kauberry/esp8266-garage-door-opener/README.md

# esp8266-garage-door-opener
An IoT garage door opener using MQTT for status reporting and web api's for control functions
