kauberry/esp8266-garage-door-opener/hardware/schematics/GDO As Built Schematic (Rough).pdf

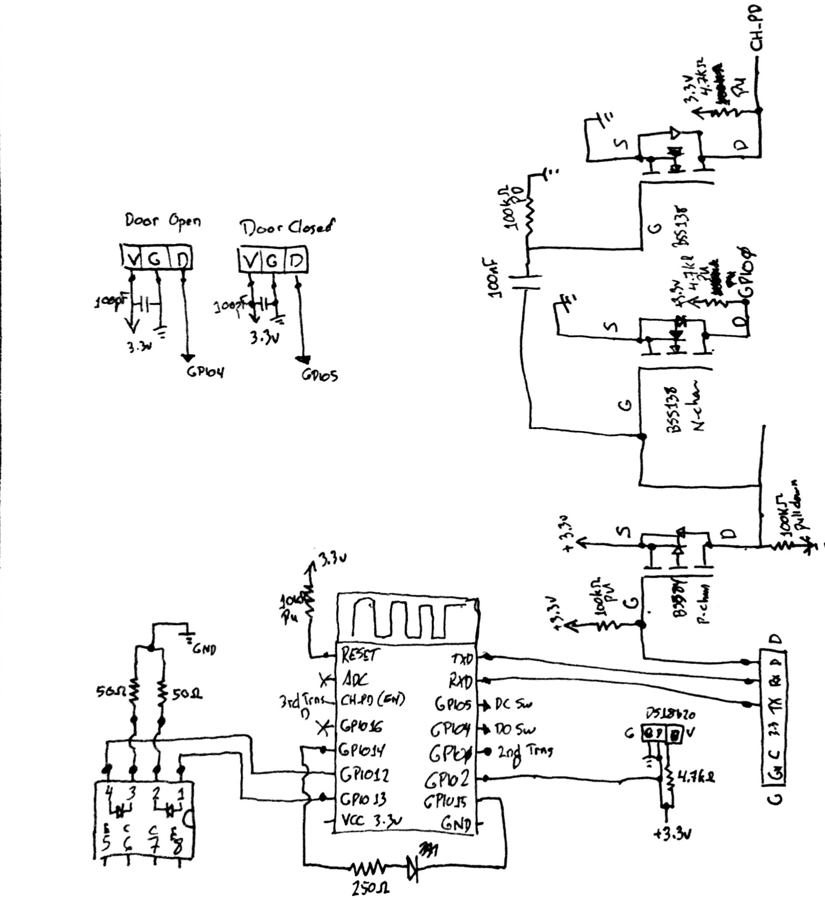
[picture p1: page 1]
