kauberry/esp8266-garage-door-opener/hardware/mounting/sketchup files/Combined.stl

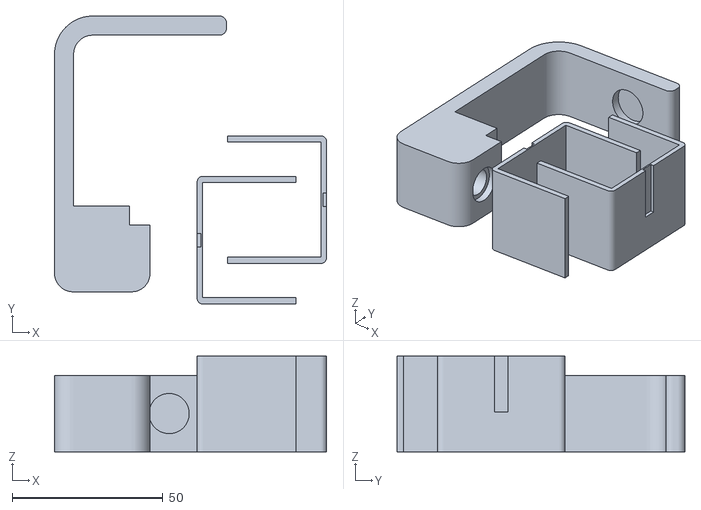
[picture p2: CAD file, 2017-11-30]
hardware/mounting/sketchup files/Combined.stl
90.4 x 95.7 x 31.8
