kauberry/esp8266-garage-door-opener/hardware/mounting/stl files/Sensor Mount v4.stl

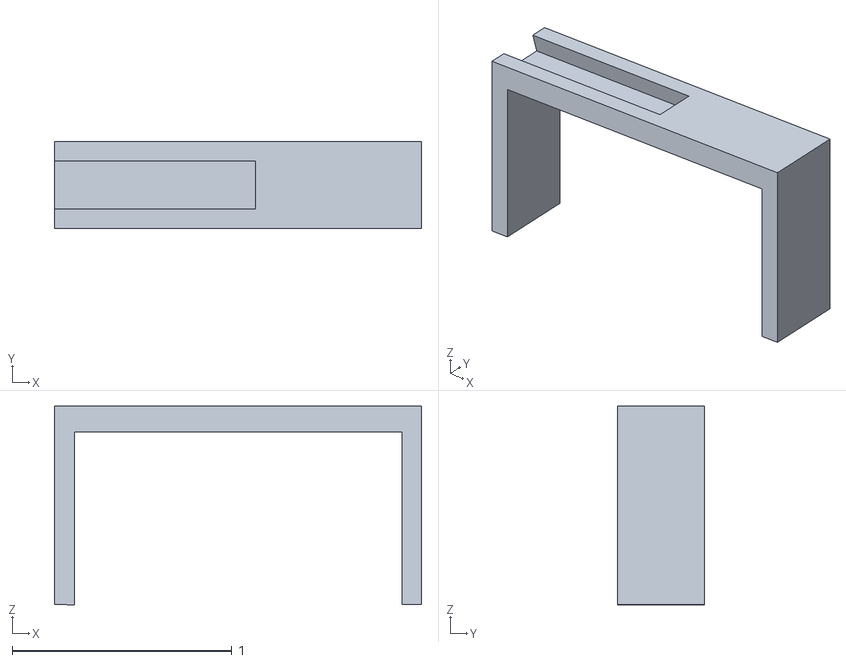
[picture p3: CAD file, 2017-11-30]
hardware/mounting/stl files/Sensor Mount v4.stl
1.67 x 0.394 x 0.903
