kauberry/esp8266-garage-door-opener/hardware/mounting/stl files/Magnet_mount - Rev 4.stl

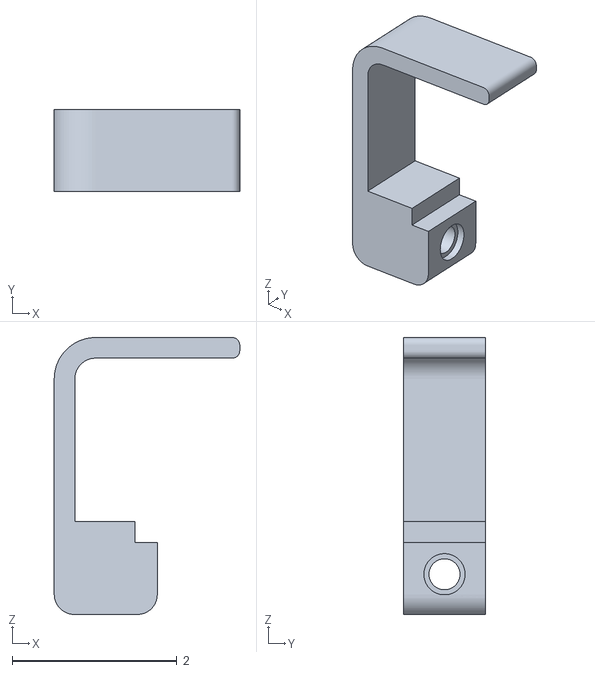
[picture p4: CAD file, 2016-04-26]
hardware/mounting/stl files/Magnet_mount - Rev 4.stl
2.25 x 1.00 x 3.36
