kauberry/esp8266-garage-door-opener/hardware/mounting/stl files/Sensor Mount v3.stl

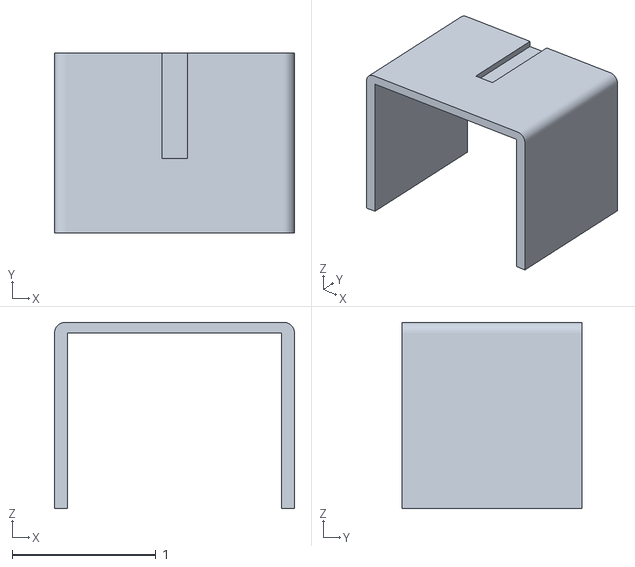
[picture p5: CAD file, 2016-04-26, an earlier design]
hardware/mounting/stl files/Sensor Mount v3.stl
1.67 x 1.25 x 1.30
