kauberry/esp8266-garage-door-opener/hardware/mounting/stl files/Magnet_mount.stl

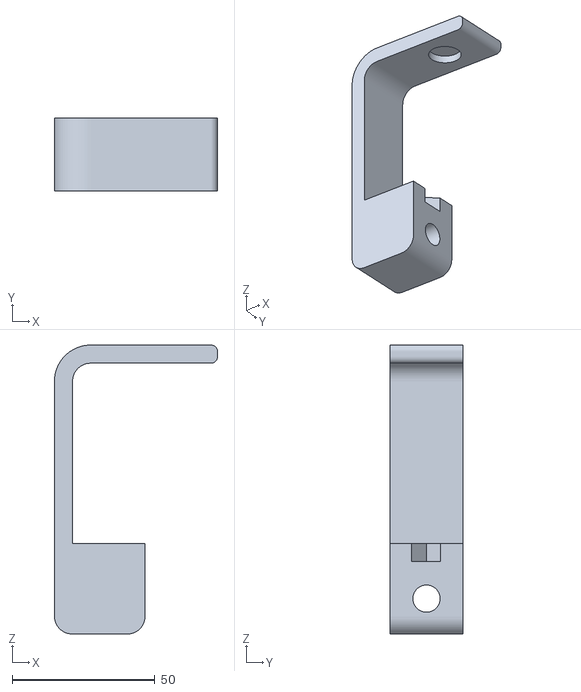
[picture p6: CAD file, 2016-04-25, an earlier design]
hardware/mounting/stl files/Magnet_mount.stl
57.1 x 25.4 x 101.2
