kauberry/esp8266-garage-door-opener/hardware/mounting/stl files/Magnet_mount - Rev 3.stl

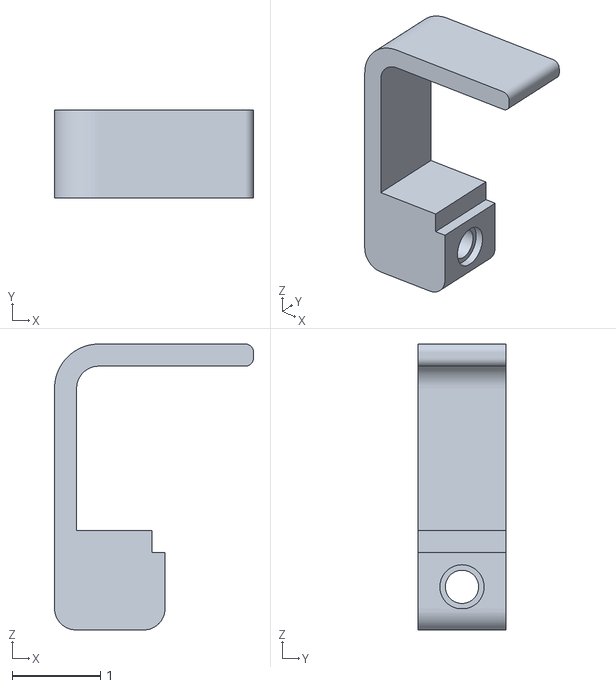
[picture p7: CAD file, 2016-04-25, an earlier design]
hardware/mounting/stl files/Magnet_mount - Rev 3.stl
2.25 x 1.00 x 3.23
