kauberry/esp8266-garage-door-opener/(list of files, cad)

Other CAD files:
hardware/mounting/stl files/Sensor Mount v2.stl
hardware/mounting/stl files/Sensor Mount v1.stl
hardware/mounting/sketchup files/Combined.skp
hardware/mounting/sketchup files/Garage Door Rail Outline.skp
hardware/mounting/sketchup files/Garage Door Rail.skp
hardware/mounting/sketchup files/Garage Monitor Enclosure.skp
hardware/mounting/sketchup files/Magnet_mount - Rev 2.skp
hardware/mounting/sketchup files/Magnet_mount - Rev 3.skp
hardware/mounting/sketchup files/Magnet_mount - Rev 4.skp
hardware/mounting/sketchup files/Magnet_mount.skp
hardware/mounting/sketchup files/Sensor Mount v2.skp
hardware/mounting/sketchup files/Sensor Mount v3.skp
hardware/mounting/sketchup files/Sensor Mount v4.skp
hardware/mounting/sketchup files/Sensor Mount.skp
