kauberry/esp8266-garage-door-opener/hardware/boards/GDOv5 Board/GDOv5 Board.brd

## EAGLE design hardware/boards/GDOv5 Board/GDOv5 Board.brd (2016-07-12)

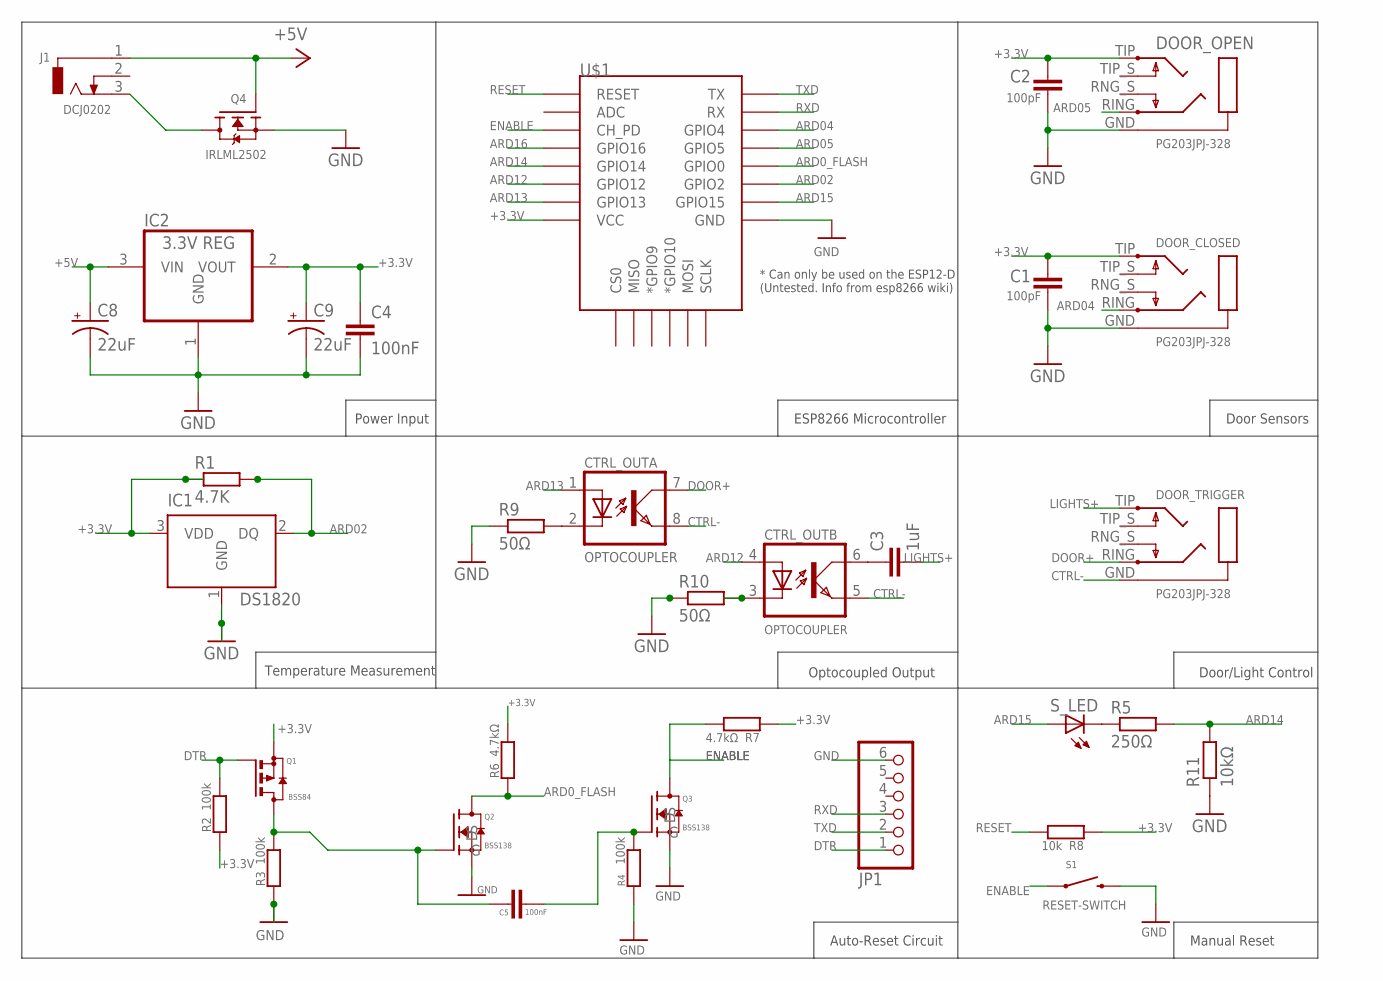
[picture p8: schematic GDOv5 Board.sch]

Parts:
C1, C2: 100pF; C1206
C3: 1uF; 1206
C4, C5: 100nF; C1206
C8, C9: 22uF; EIA3216
CTRL_OUT: OPTOCOUPLER; DIL08
DOOR_CLOSED: PG203JPJ-328; PG203J
DOOR_OPEN: PG203JPJ-328; PG203J
DOOR_TRIGGER: PG203JPJ-328; PG203J
IC1: DS1820; TO-92
IC2: 3.3V REG; SOT223
J1: DCJ0202
JP1: PINHD-1X6; 1X06
Q1: BSS84; SOT23
Q2, Q3: BSS138
Q4: IRLML2502; SOT23
R1: 4.7K; M3216
R2, R3, R4: 100k; M3216
R5: 250Ω; M3216
R6, R7: 4.7kΩ; M3216
R8: 10k; M3216
R9, R10: 50Ω; M3216
R11: 10kΩ; M3216
S1: RESET-SWITCH; TACTILE-SWITCH-1101NE
S_LED: LED5MM
U$1: ESP12ESMD; ESP12E-SMD

Connections:
+3.3V: C1.1, C2.1, C4.1, C9.A (+), DOOR_CLOSED.TIP (5), DOOR_OPEN.TIP (5), IC1.3 (VDD), IC2.2 (VOUT), Q1.2 (S), R1.1, R2.1, R6.2, R7.1, R8.1, U$1.VCC
+5V: C8.A (+), IC2.3 (VIN), J1.1, Q4.1 (G)
ARD0_FLASH: Q2.D, R6.1, U$1.GPIO0
ARD02: IC1.2 (DQ), R1.2, U$1.GPIO2
ARD04: DOOR_CLOSED.RING (2), U$1.GPIO4
ARD05: DOOR_OPEN.RING (2), U$1.GPIO5
ARD12: CTRL_OUT.4 (A), U$1.GPIO12
ARD13: CTRL_OUT.1 (A), U$1.GPIO13
ARD14: R5.2, R11.2, U$1.GPIO14
ARD15: S_LED.A, U$1.GPIO15
ARD16: U$1.GPIO16
CTRL-: CTRL_OUT.5 (EMIT), CTRL_OUT.8 (EMIT), DOOR_TRIGGER.GND (1)
DOOR+: CTRL_OUT.7 (COL), DOOR_TRIGGER.RING (2)
DTR: JP1.1, Q1.1 (G), R2.2
ENABLE: Q3.D, R7.2, S1.P$1 (1), U$1.CH_PD
GND: C1.2, C2.2, C4.2, C8.C (-), C9.C (-), DOOR_CLOSED.GND (1), DOOR_OPEN.GND (1), IC1.1 (GND), IC2.1 (GND), JP1.6, Q2.S, Q3.S, Q4.2 (S), R3.1, R4.1, R9.1, R10.1, R11.1, S1.P$2 (2), U$1.GND
LIGHTS+: C3.2, DOOR_TRIGGER.TIP (5)
unnamed: J1.3, Q4.3 (D)
unnamed: C5.2, Q3.G, R4.2
unnamed: C3.1, CTRL_OUT.6 (COL)
unnamed: R5.1, S_LED.K (C)
unnamed: C5.1, Q1.3 (D), Q2.G, R3.2
unnamed: CTRL_OUT.2 (C), R9.2
unnamed: CTRL_OUT.3 (C), R10.2
RESET: R8.2, U$1.RESET
RXD: JP1.3, U$1.RXD0 (RX)
TXD: JP1.2, U$1.TXD0 (TX)

Notes on the sheet:
Power Input
Temperature Measurement
ESP8266 Microcontroller
Optocoupled Output
Door Sensors
Door/Light Control
Auto-Reset Circuit
Manual Reset

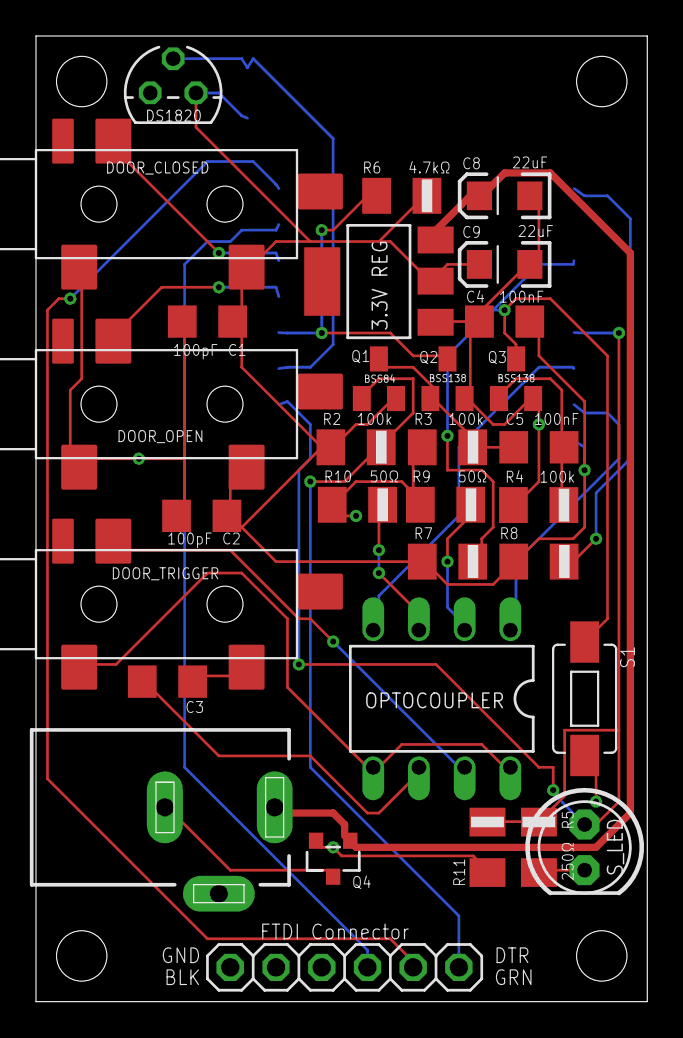
[picture p9: board GDOv5 Board.brd from above]

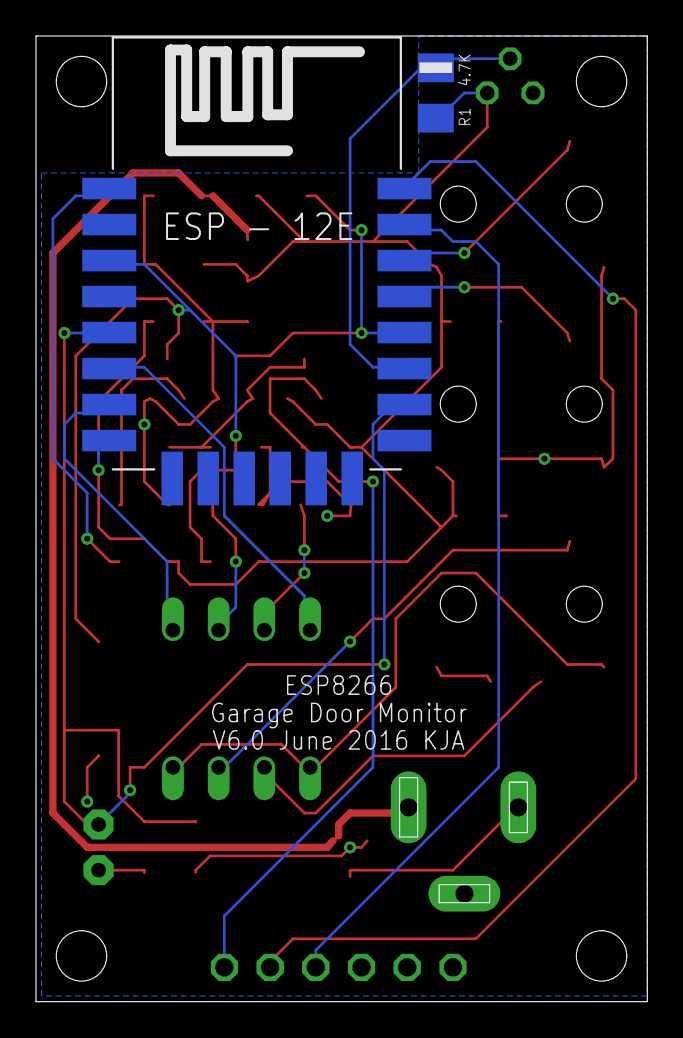
[picture p10: board GDOv5 Board.brd from below]

Board: 2 copper layers, 34.0 x 53.6 mm, 33 parts (2 on the bottom side), 26 nets.
