kauberry/esp8266-garage-door-opener/(commit log)

2016-04-20 Adding initial Eagle files
    [GDOv5 Board.sch]
2016-04-21 Adding sensor mount Sketchup file
    [Sensor Mount.skp]
2016-04-25 Updating model files for mounting hardware
    [Garage Door Rail Outline.skp, Garage Door Rail.skp, Magnet_mount - Rev 2.skp, Magnet_mount - Rev 3.skp, Magnet_mount - Rev 3.stl, Magnet_mount.skp, Magnet_mount.stl, Sensor Mount - Rev 1.stl]
2016-04-25 Adding initial EagleCAD files for controller board
    [GDOv5 Board.brd, GDOv5 Board.sch]
2016-04-25 Updating routing and layout
    [GDOv5 Board.brd, GDOv5 Board.sch]
2016-04-26 Mostly final board design
    [GDOv5 Board.brd, GDOv5 Board.sch]
2016-04-26 Closer to final board design
    [GDOv5 Board.brd, GDOv5 Board.sch]
2016-04-26 Added dimensions to board layout
    [GDOv5 Board.brd]
2016-04-26 Added first cut at a 3D printed enclosure
    [Garage Monitor Enclosure.skp]
2016-04-26 Updated sensor and magnet mounts
    [Magnet_mount - Rev 4.skp, Magnet_mount - Rev 4.stl, Sensor Mount v3.skp, Sensor Mount v3.stl]
2016-04-27 Added resistor for optocoupler inputs
    [GDOv5 Board.brd, GDOv5 Board.sch]
2016-04-29 More board tweaks
    [GDOv5 Board.brd, GDOv5 Board.sch]
2016-05-11 Replacing 3.5mm Jack with SMT design
    [GDOv5 Board.brd, GDOv5 Board.sch]
2016-05-11 Redesigning main board for more SMT components
    [GDOv5 Board.brd, GDOv5 Board.sch]
2016-05-11 Switching over to ESP-12e
2016-05-13 Updating main board files
    [GDOv5 Board.brd, GDOv5 Board.sch]
2016-05-15 Finalized version of board for OshPark
    [GDOv5 Board.brd, GDOv5 Board.sch]
2016-05-16 Fixing bad pull down connection in auto-reset circuit
    [GDOv5 Board.brd, GDOv5 Board.sch]
2016-05-31 Added pullup resistor for GPIO0
    [GDOv5 Board.brd, GDOv5 Board.sch]
2016-06-15 Fixing Board issues
    [GDOv5 Board.brd, GDOv5 Board.sch]
2016-06-20 Updating board to better match prototype design
    [GDOv5 Board.brd, GDOv5 Board.sch]
2016-06-20 Fixing state indicator LED's to update immediately on startup Increasing delay between mandatory reporting intervals for temperature
    [garage_monitor_controller.ino]
2016-06-21 Tweaked power rails and updated descriptive text before sending to fab
    [GDOv5 Board.brd, GDOv5 Board.sch]
2016-07-12 Board Design: Changed power supply buffer caps from 10µF to 22µF. Flipped Status LED connections for proper polarity. Added 10kΩ on GPIO15 to match with adapter board design on prototype.
    [GDOv5 Board.brd, GDOv5 Board.sch]
2016-07-12 Software: More fixes for configuration logic. Removed SPIFFS conf file loading for now. Added code to handle the additional external temperature probe
    [garage_monitor_controller.ino]
2016-11-10 Updates to mounting hardware for better fit and clearance
    [Combined.skp, Combined.stl, Magnet_mount - Rev 4.skp, Sensor Mount v4.skp]
2017-11-30 Pushing updated hardware and Eagle component libraries
    [Sensor Mount v1.stl, Sensor Mount v4.skp, Sensor Mount v4.stl]
