kauberry/esp8266-garage-door-opener/(notices)

Notices in the files:
parts and their libraries:
SparkFun-Capacitors: Licensing: CC v3.0 Share-Alike You are welcome to use this library for commercial purposes.
